xobs/soundoff/Soundoff.png

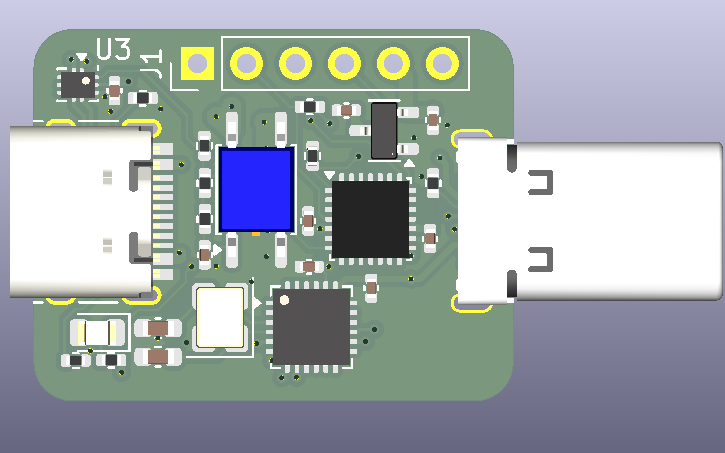
Soundoff.png
