xobs/soundoff/step/2.54SOP4.step

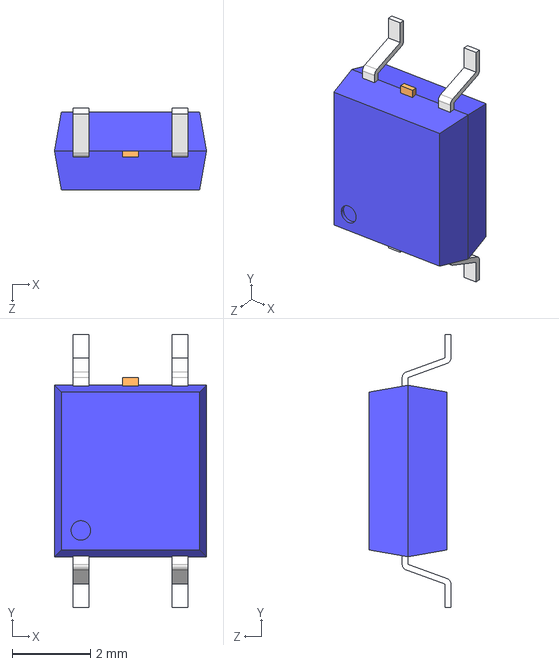
[picture p3: CAD file, 2025-09-11]
step/2.54SOP4.step
3.90 x 7.00 x 2.10 mm
