xobs/soundoff/step/UFQFPN28-4x4-05.step

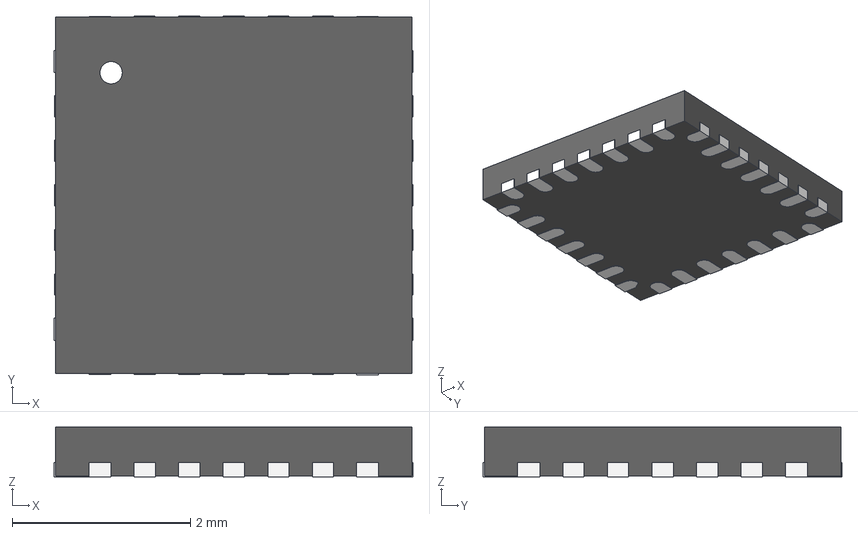
[picture p4: CAD file, 2025-09-11]
step/UFQFPN28-4x4-05.step
4.03 x 4.02 x 0.56 mm
Pin001
CPin001
CPin002
Pin002
Pin003
Pin004
Pin005
CPin003
CPin004
CPin005
CPin006
CPin007
CPin008
