xobs/soundoff/step/USB Connector Type A female.STEP

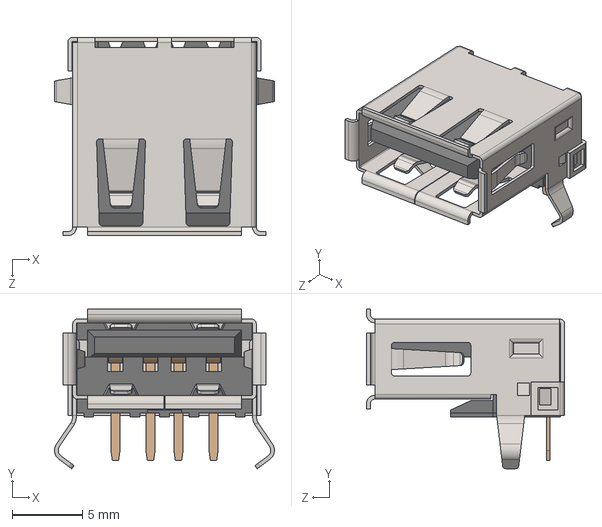
[picture p5: CAD file, 2025-09-11]
step/USB Connector Type A female.STEP
15.7 x 11.4 x 14.1 mm
