xobs/soundoff/Soundoff-V3.pdf

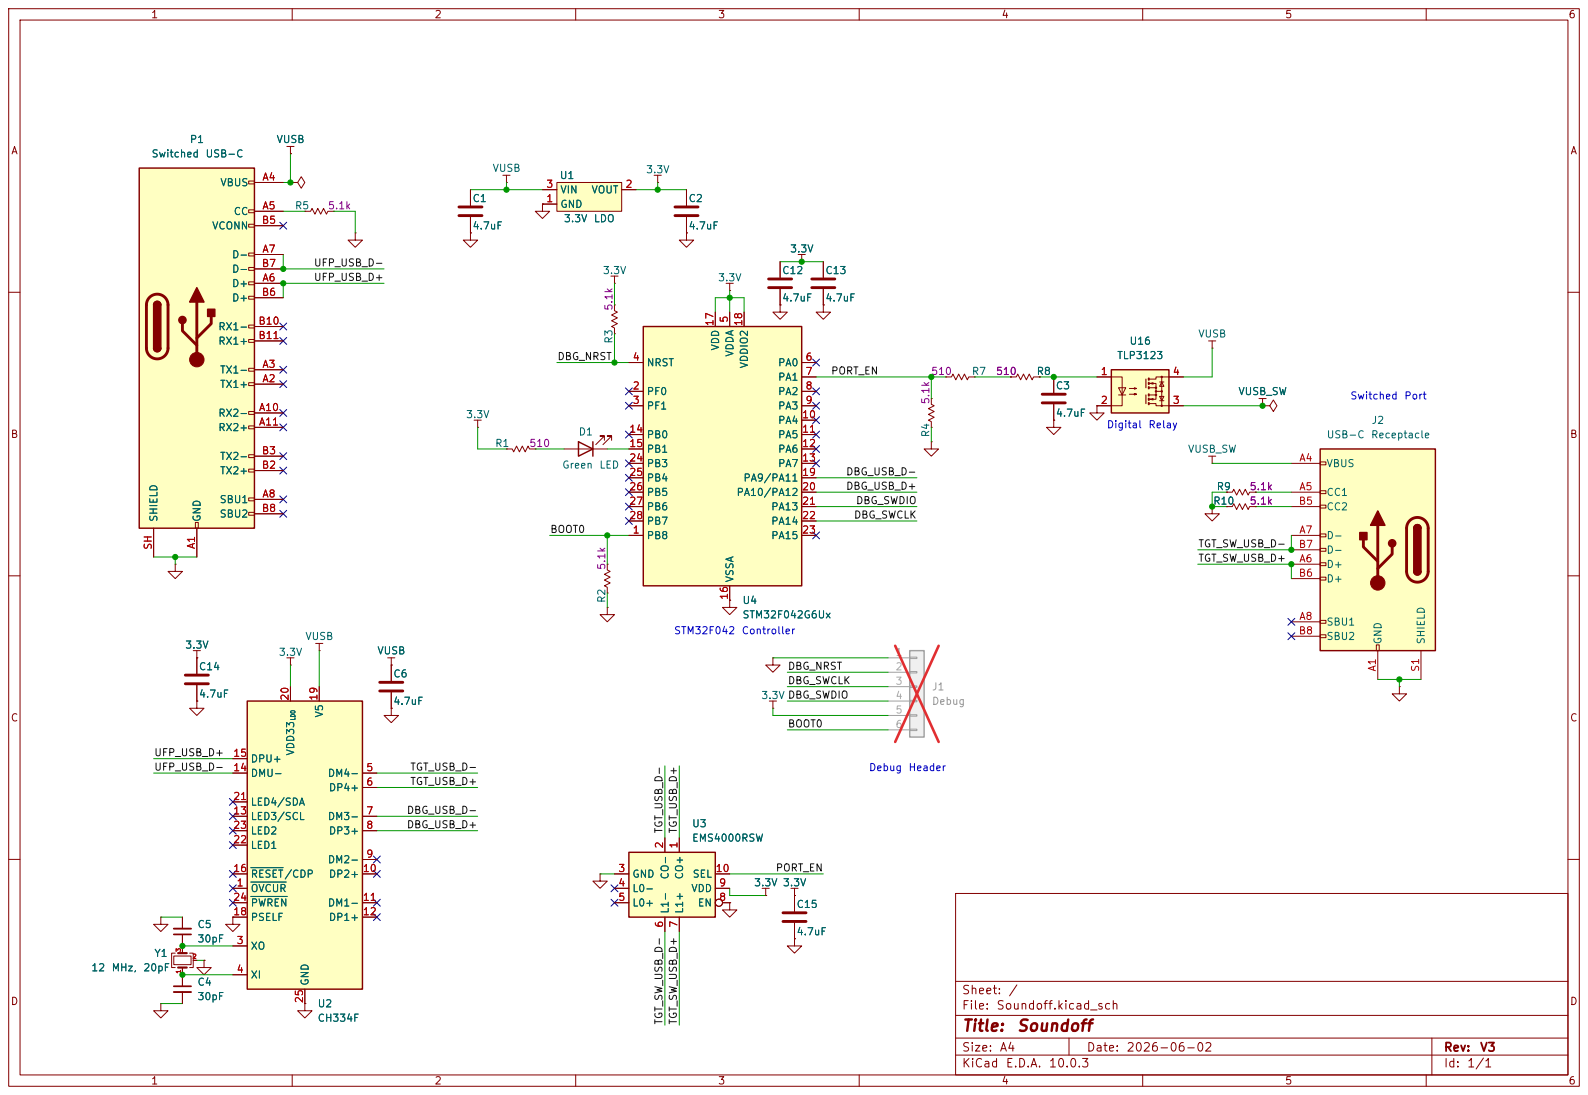
[picture p6: page 1]

Size: A4 | Rev: V3
KiCad E.D.A. 10.0.3 | Id: 1/1
