xobs/soundoff/Soundoff.kicad_pcb

## KiCad design Soundoff.kicad_pcb (2026-06-02)

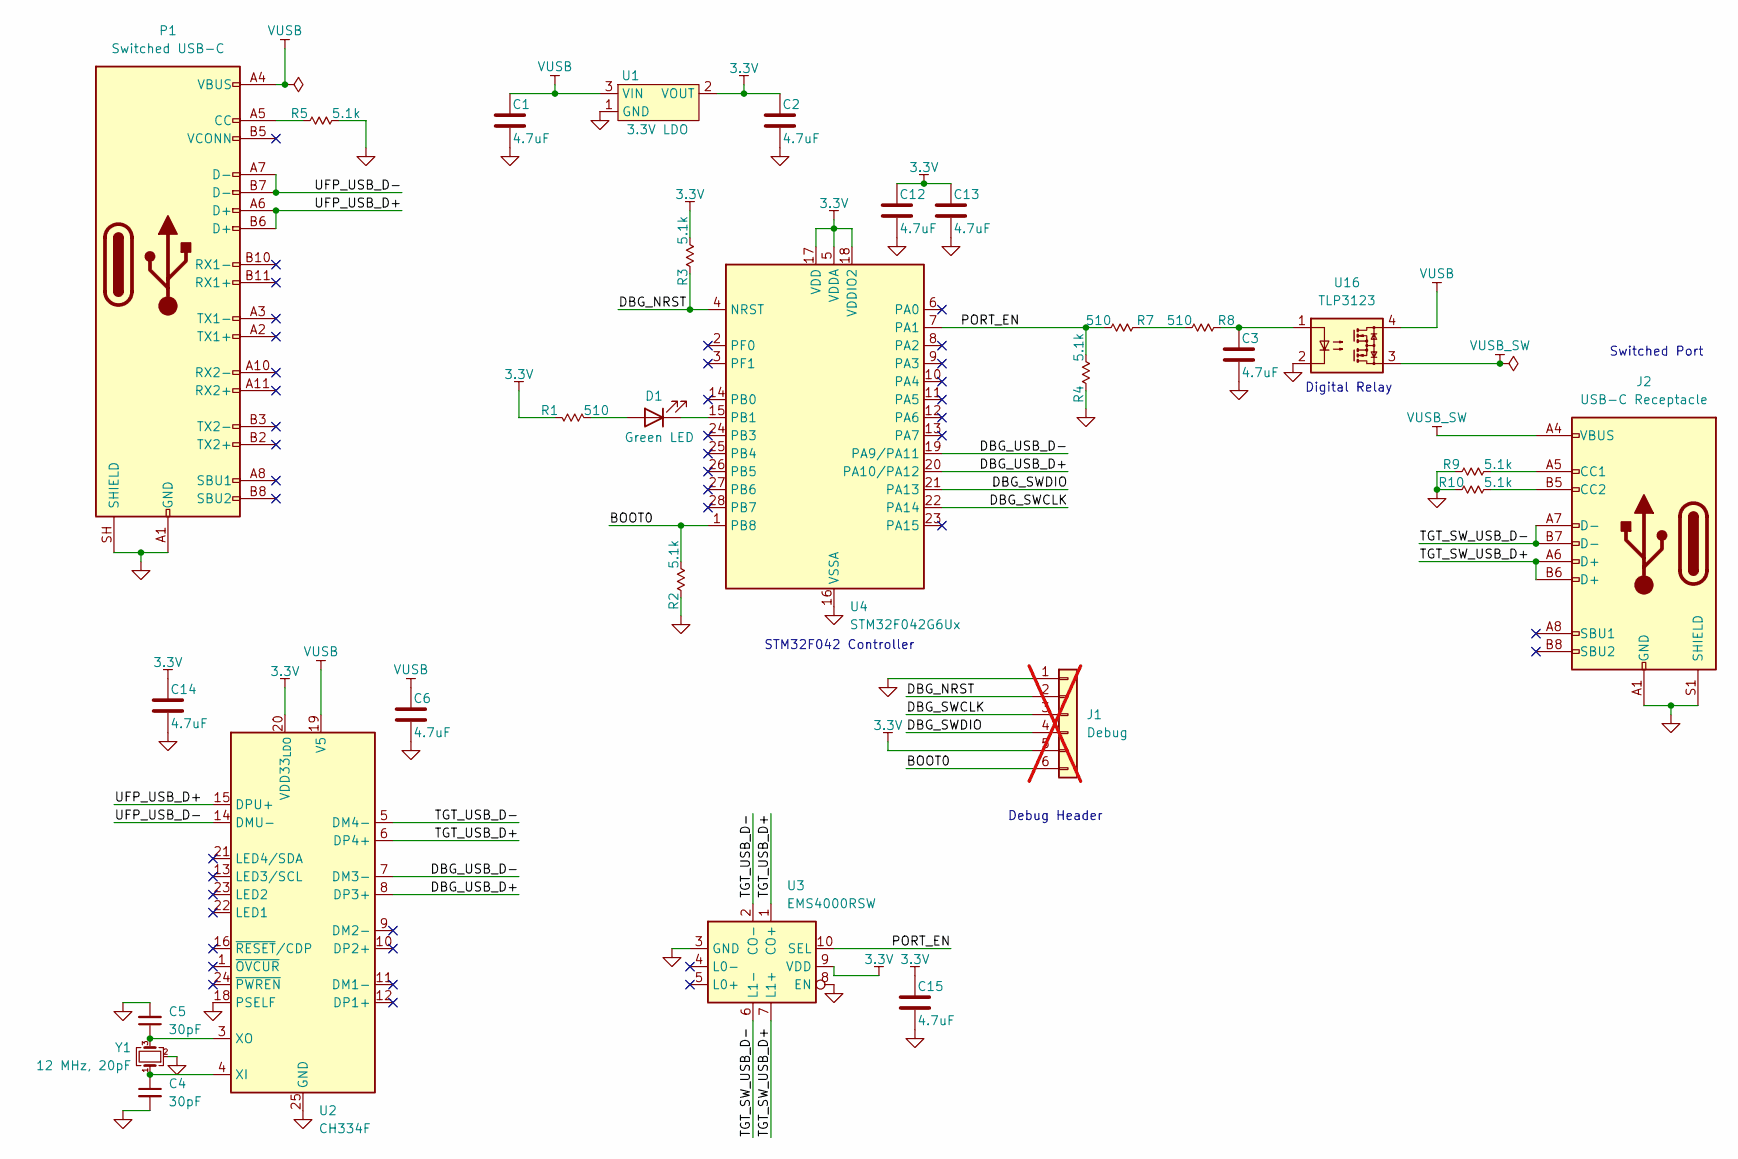
[picture p7: schematic Soundoff.kicad_sch]

Parts:
C1, C2, C3, C6, C12, C13, C14, C15: 4.7uF; C_0402_1005Metric; MPN CL05A475MP5NRNC; LCSC C23733
C4, C5: 30pF; C_0603_1608Metric; MPN 0603CG300J500NT; LCSC C1658
D1: Green LED; LED_0805_2012Metric; MPN KT-0805G; LCSC C2297
J1: Debug; PinHeader_1x06_P2.54mm_Vertical; not fitted
J2: USB-C Receptacle; USB_C_Receptacle_HRO_TYPE-C-31-M-12; MPN TYPE-C 16PIN 2MD(073); LCSC C2765186
P1: Switched USB-C; USB-C-SMD_TYPE-C-31-G-07-1; MPN 13001-UCAM001-X; LCSC C3148223
R1, R7, R8: R 510 0402; R_0402_1005Metric; MPN 0402WGF5100TCE; LCSC C25123
R2, R3, R4, R5, R9, R10: R 5.1k 0402; R_0402_1005Metric; MPN 0402WGF5101TCE; LCSC C25905
U1: 3.3V LDO; SOT-23-3; MPN XC6206P332MR-G; LCSC C5446
U2: CH334F; QFN-24-1EP_4x4mm_P0.5mm_EP2.7x2.7mm; MPN CH334F; LCSC C5187527
U3: EMS4000RSW; QFN-10_1.4x1.8_Pitch0.4mm; MPN EMS4000RSW; LCSC C49186227
U4: STM32F042G6Ux; QFN-28_4x4mm_P0.5mm; MPN STM32F042G6U6; LCSC C961597
U16: TLP3123; SO-4_4.4x3.9mm_P2.54mm; MPN TLP3123; LCSC C20624244
Y1: 12 MHz, 20pF; Crystal_SMD_3225-4Pin_3.2x2.5mm; MPN X322512MSB4SI; LCSC C9002

Connections:
3.3V: C2.1, C12.1, C13.1, C14.1, C15.1, J1.5, R1.1, R3.1, U1.2 (VOUT), U2.20 (VDD33_{LDO}), U3.9 (VDD), U4.5 (VDDA), U4.17 (VDD), U4.18 (VDDIO2)
/BOOT0: J1.6, R2.1, U4.1 (PB8)
/DBG_NRST: J1.2, R3.2, U4.4 (NRST)
/DBG_SWCLK: J1.3, U4.22 (PA14)
/DBG_SWDIO: J1.4, U4.21 (PA13)
/DBG_USB_D+: U2.8 (DP3+), U4.20 (PA10/PA12)
/DBG_USB_D-: U2.7 (DM3-), U4.19 (PA9/PA11)
/PORT_EN: R4.1, R7.2, U3.10 (SEL), U4.7 (PA1)
/TGT_SW_USB_D+: J2.A6 (D+), J2.B6 (D+), U3.7 (L1+)
/TGT_SW_USB_D-: J2.A7 (D-), J2.B7 (D-), U3.6 (L1-)
/TGT_USB_D+: U2.6 (DP4+), U3.1 (CO+)
/TGT_USB_D-: U2.5 (DM4-), U3.2 (CO-)
/UFP_USB_D+: P1.A6 (D+), P1.B6 (D+), U2.15 (DPU+)
/UFP_USB_D-: P1.A7 (D-), P1.B7 (D-), U2.14 (DMU-)
GND: C1.2, C2.2, C3.2, C4.2, C5.2, C6.2, C12.2, C13.2, C14.2, C15.2, J1.1, J2.A1 (GND), J2.A12 (GND), J2.B1 (GND), J2.B12 (GND), J2.S1 (SHIELD), P1.A1 (GND), P1.A12 (GND), P1.B1 (GND), P1.B12 (GND), P1.SH (SHIELD), R2.2, R4.2, R5.1, R9.2, R10.2, U1.1 (GND), U2.18 (PSELF), U2.25 (GND), U3.3 (GND), U3.8 (EN), U4.16 (VSSA), U16.2, Y1.2 (G), Y1.4 (G)
unnamed: C3.1, R8.1, U16.1
unnamed: D1.2 (A), R1.2
unnamed: D1.1 (K), U4.15 (PB1)
unnamed: J2.A5 (CC1), R9.1
unnamed: J2.B5 (CC2), R10.1
unnamed: P1.A5 (CC), R5.2
unnamed: R7.1, R8.2
unnamed: C4.1, U2.4 (XI), Y1.1
unnamed: C5.1, U2.3 (XO), Y1.3
VUSB: C1.1, C6.1, P1.A4 (VBUS), P1.A9 (VBUS), P1.B4 (VBUS), P1.B9 (VBUS), U1.3 (VIN), U2.19 (V5), U16.4
VUSB_SW: J2.A4 (VBUS), J2.A9 (VBUS), J2.B4 (VBUS), J2.B9 (VBUS), U16.3

Notes on the sheet:
STM32F042 Controller
Switched Port
Debug Header
Digital Relay

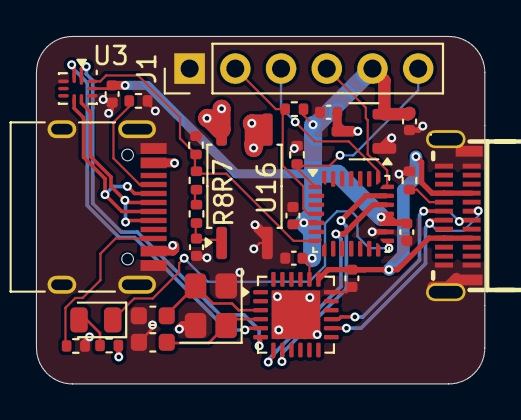
[picture p8: board Soundoff.kicad_pcb from above]

Board: 4 copper layers, 24.9 x 19.3 mm, 29 parts (0 on the bottom side), 26 nets.
