xobs/soundoff/(commit log)

2026-06-01 v2: make usb-c and pass data through
    [Soundoff.kicad_sch, bom.csv, designators.csv, positions.csv]
2026-06-02 v3: fix usb polarity
    The USB polarity was incorrect -- the DFP and UFP roles were swapped.
    Change the connectors around to make it correct now.
    [Soundoff.kicad_pcb, Soundoff.kicad_sch, bom.csv, designators.csv, positions.csv]
